fintros/SDrive-ARM/docs/SDriveARM_Board.pdf

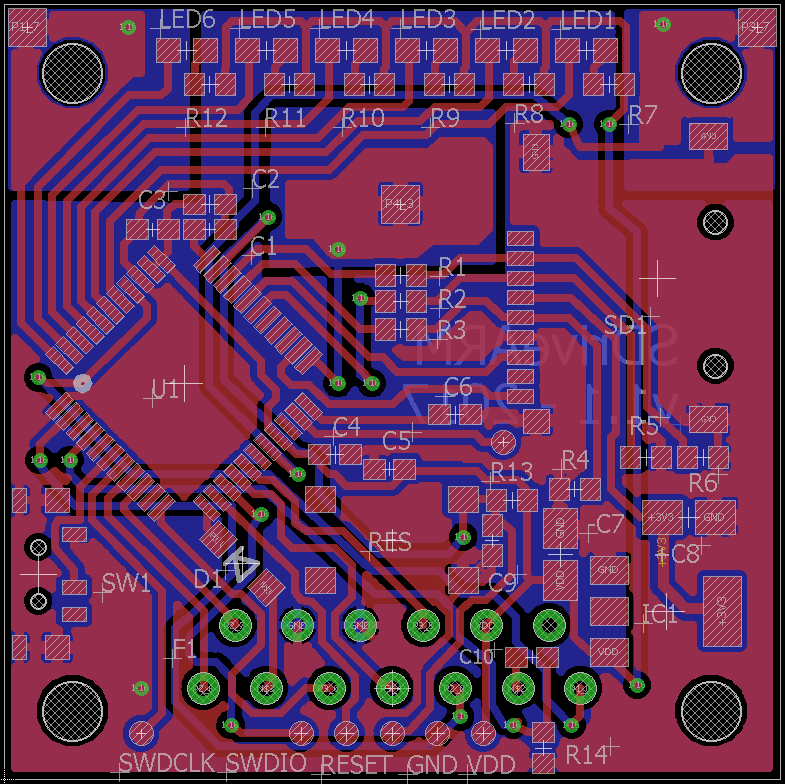
[picture p3: figure]
