fintros/SDrive-ARM/docs/photos/onplace01.jpg

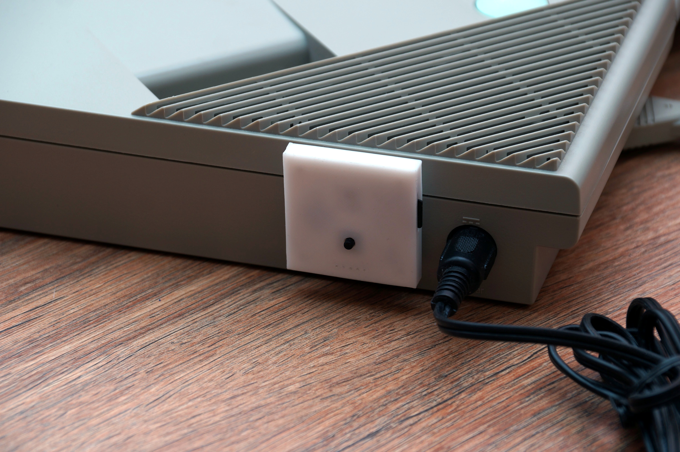
docs/photos/onplace01.jpg
