fintros/SDrive-ARM/docs/photos/onplace02.jpg

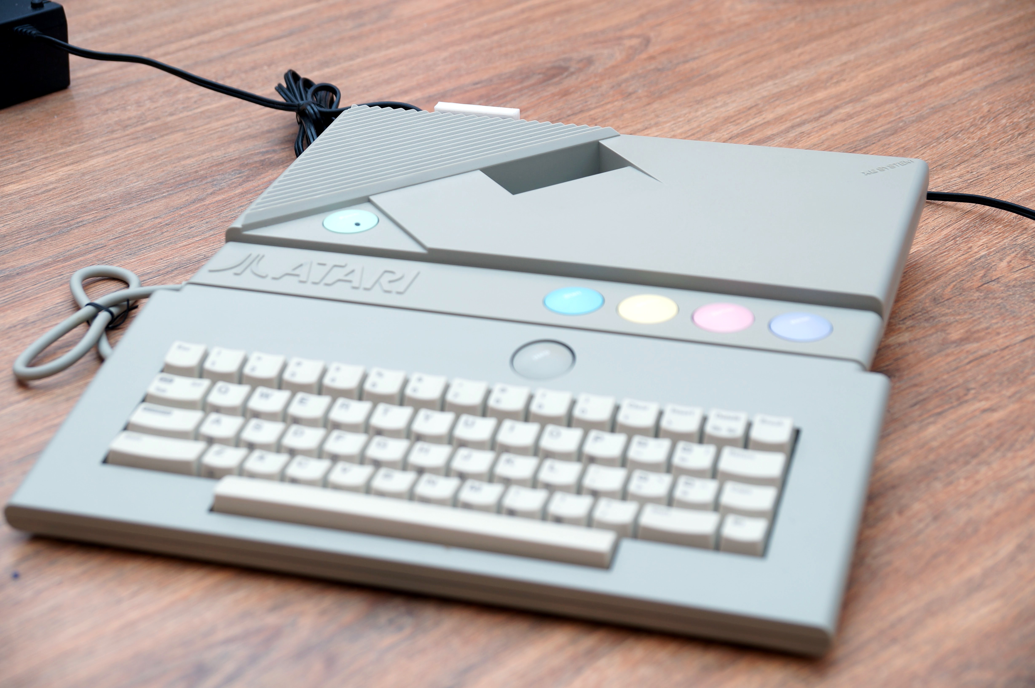
docs/photos/onplace02.jpg
