fintros/SDrive-ARM/docs/photos/onplace03.jpg

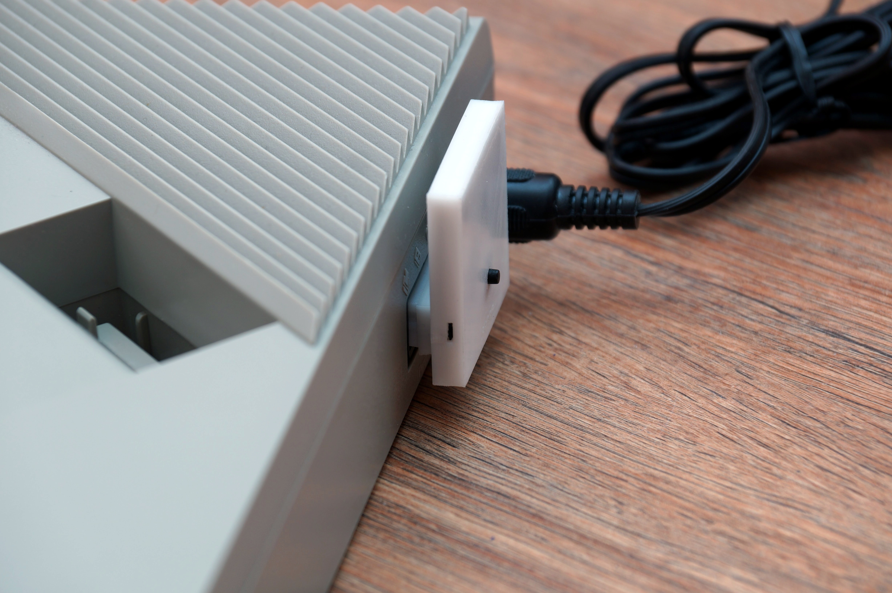
docs/photos/onplace03.jpg
