fintros/SDrive-ARM/docs/photos/onplace04.jpg

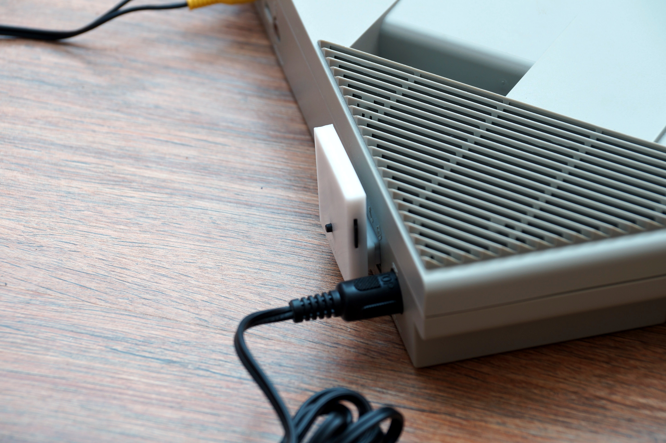
docs/photos/onplace04.jpg
