fintros/SDrive-ARM/docs/photos/onplace05.jpg

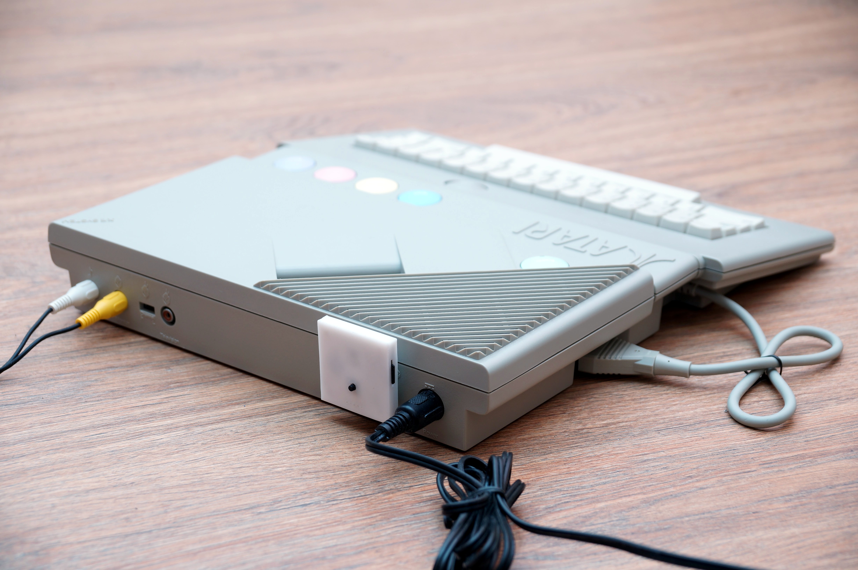
docs/photos/onplace05.jpg
