fintros/SDrive-ARM/docs/photos/view01.jpg

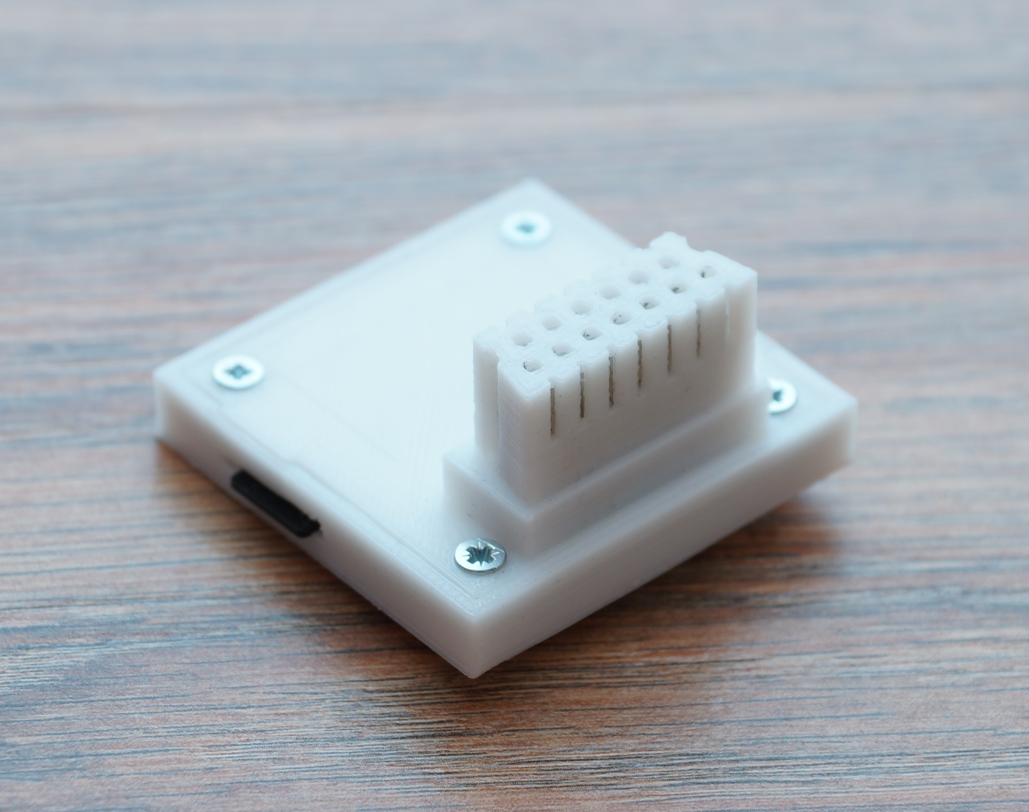
docs/photos/view01.jpg
