fintros/SDrive-ARM/docs/photos/view02.jpg

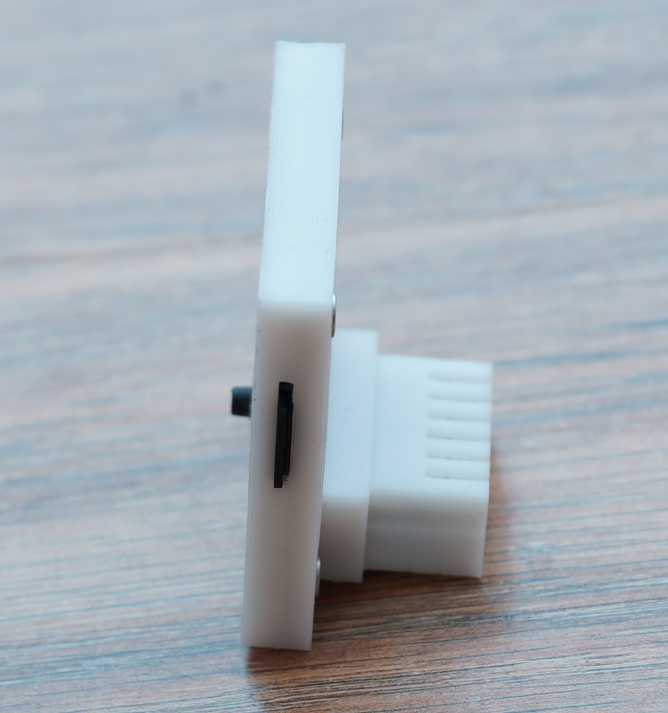
docs/photos/view02.jpg
