fintros/SDrive-ARM/docs/photos/view03.jpg

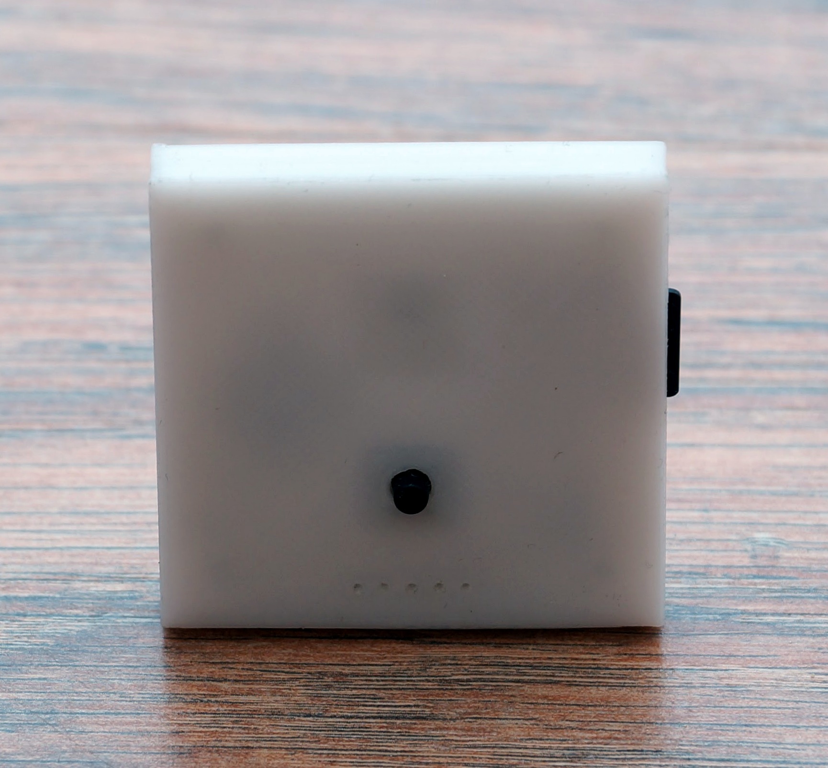
docs/photos/view03.jpg
