fintros/SDrive-ARM/docs/photos/view04.jpg

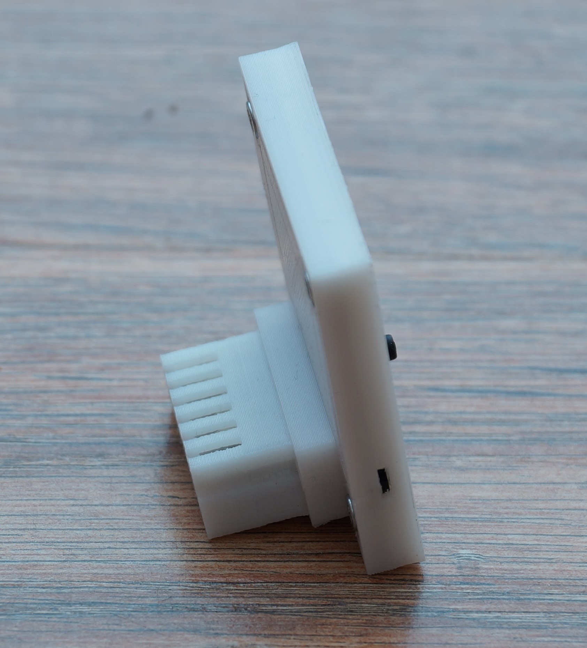
docs/photos/view04.jpg
