fintros/SDrive-ARM/docs/SDriveARM_Board.png

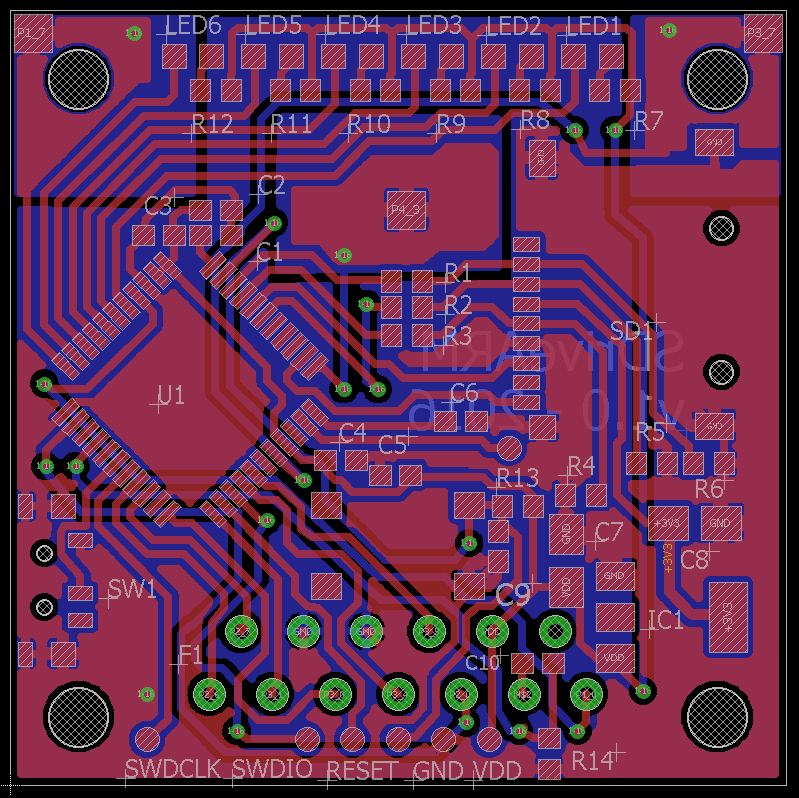
docs/SDriveARM_Board.png
