fintros/SDrive-ARM/box/bot.stl

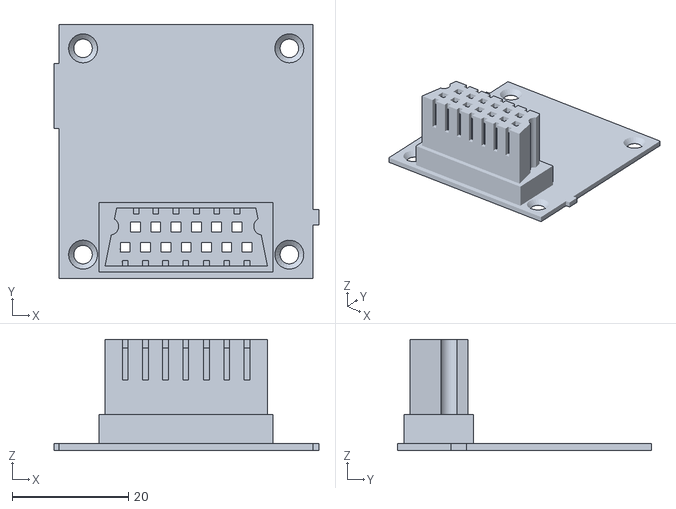
[picture p14: CAD file, 2022-09-16]
box/bot.stl
45.7 x 43.8 x 19.2
