fintros/SDrive-ARM/box/top.stl

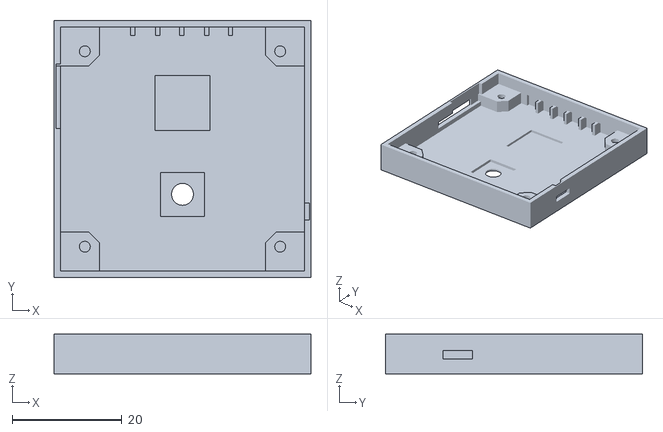
[picture p15: CAD file, 2022-09-16]
box/top.stl
46.8 x 46.8 x 7.21
