fintros/SDrive-ARM/docs/photos/build01.jpg

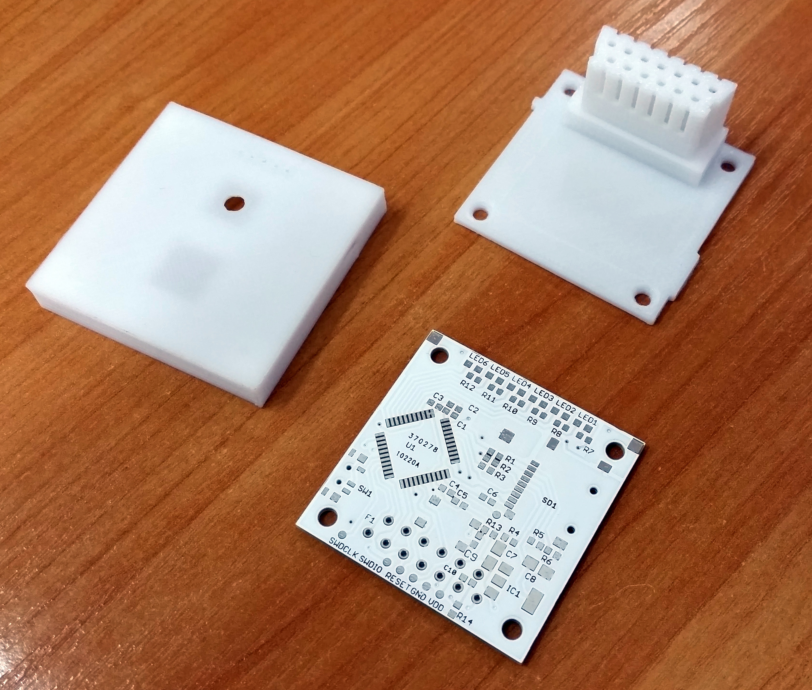
docs/photos/build01.jpg
