fintros/SDrive-ARM/docs/photos/build02.jpg

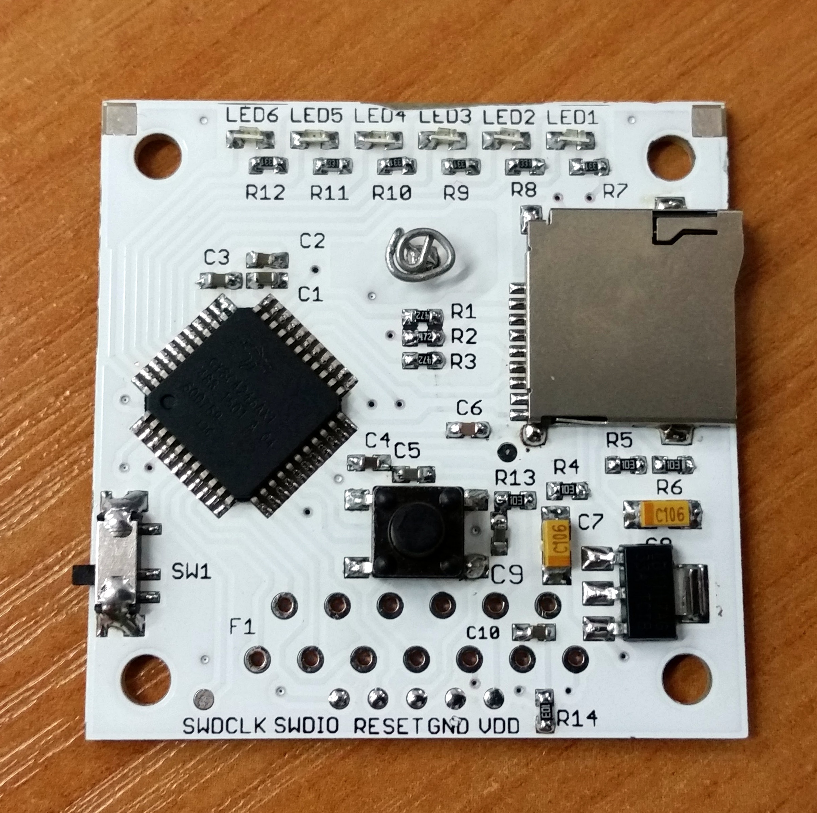
docs/photos/build02.jpg
