fintros/SDrive-ARM/docs/photos/build03.jpg

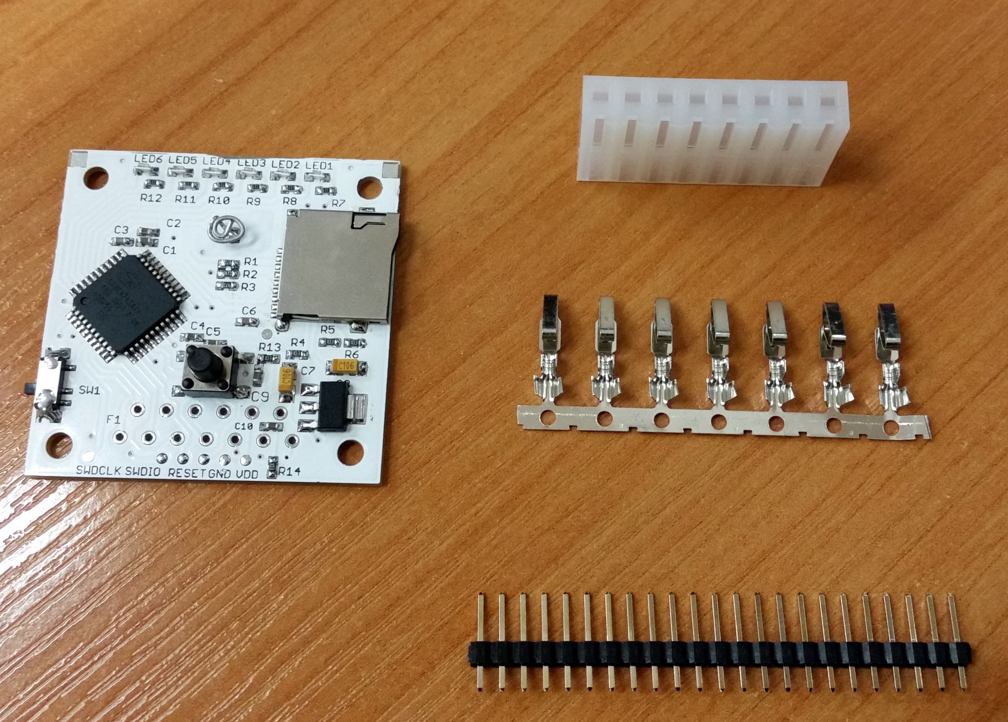
docs/photos/build03.jpg
