fintros/SDrive-ARM/docs/photos/build04.jpg

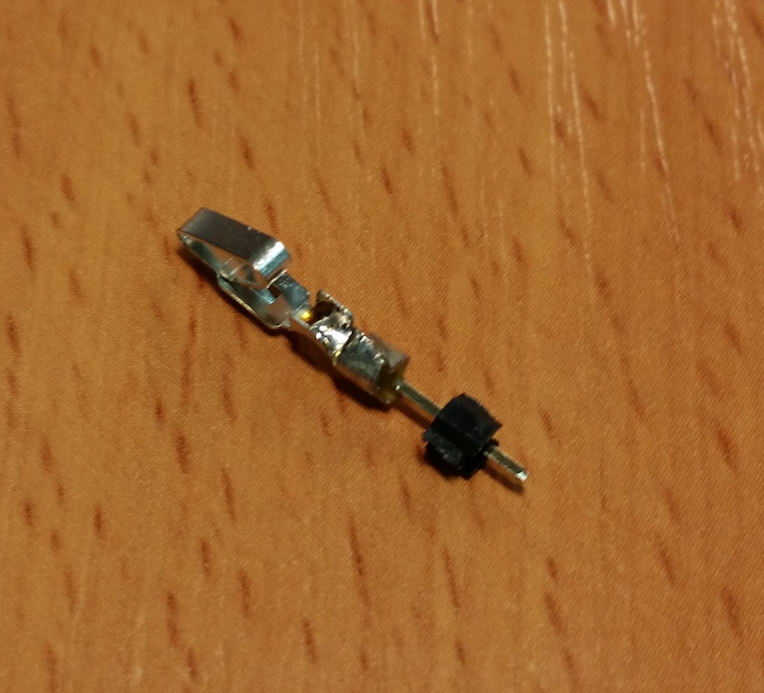
docs/photos/build04.jpg
