fintros/SDrive-ARM/docs/photos/build05.jpg

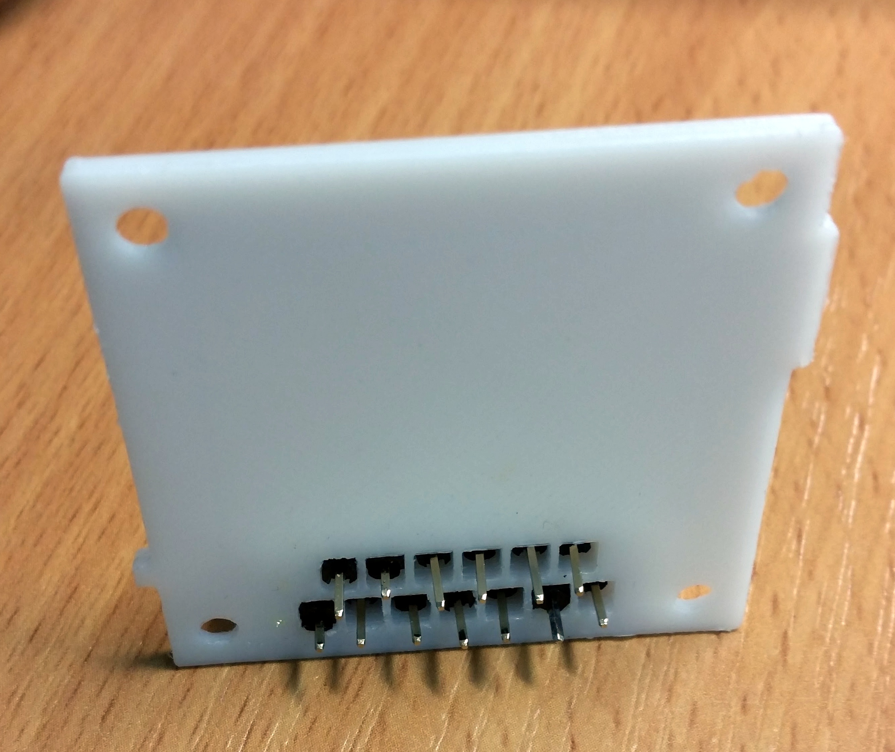
docs/photos/build05.jpg
