fintros/SDrive-ARM/docs/photos/build06.jpg

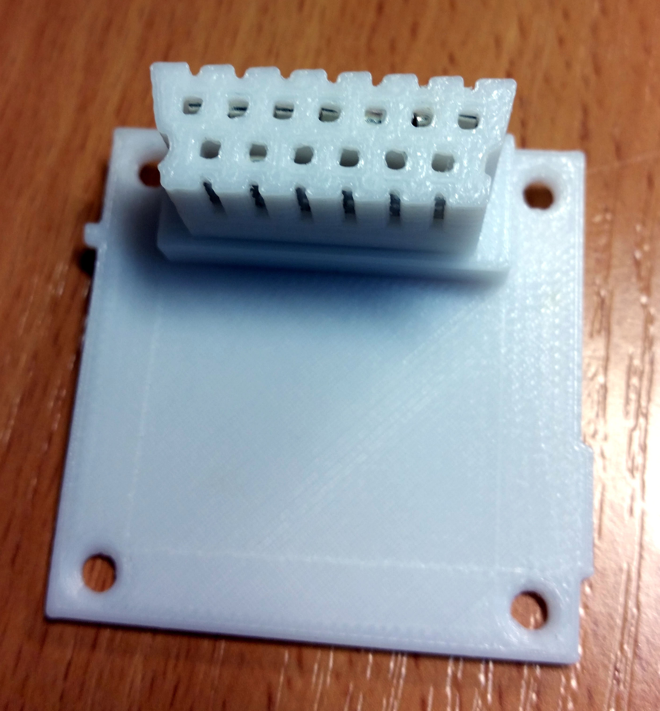
docs/photos/build06.jpg
