fintros/SDrive-ARM/docs/SDriveARM_Scheme.pdf

## MicroSD card Processor

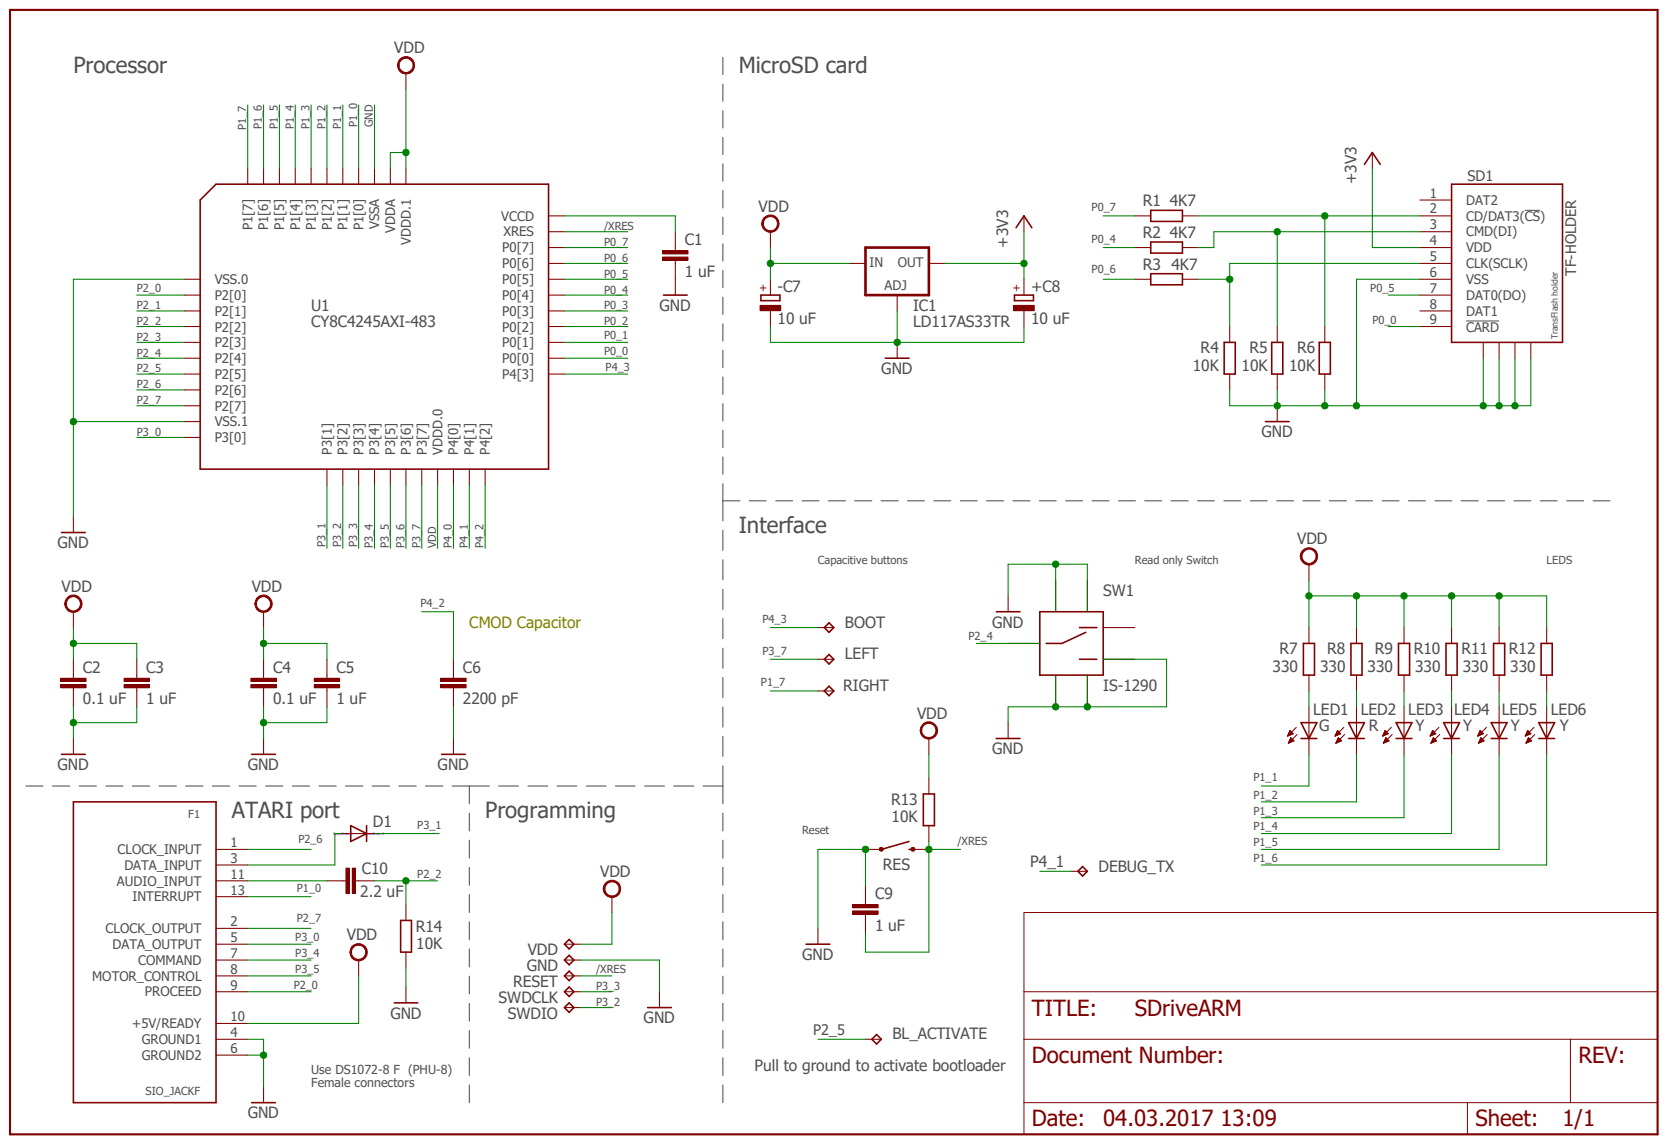
[picture p22: page 1]

CMD(DI) 3
VDD 4

VSS 6
