fintros/SDrive-ARM/hardware/SDriveARM.brd

## EAGLE design hardware/SDriveARM.brd (2017-03-04)

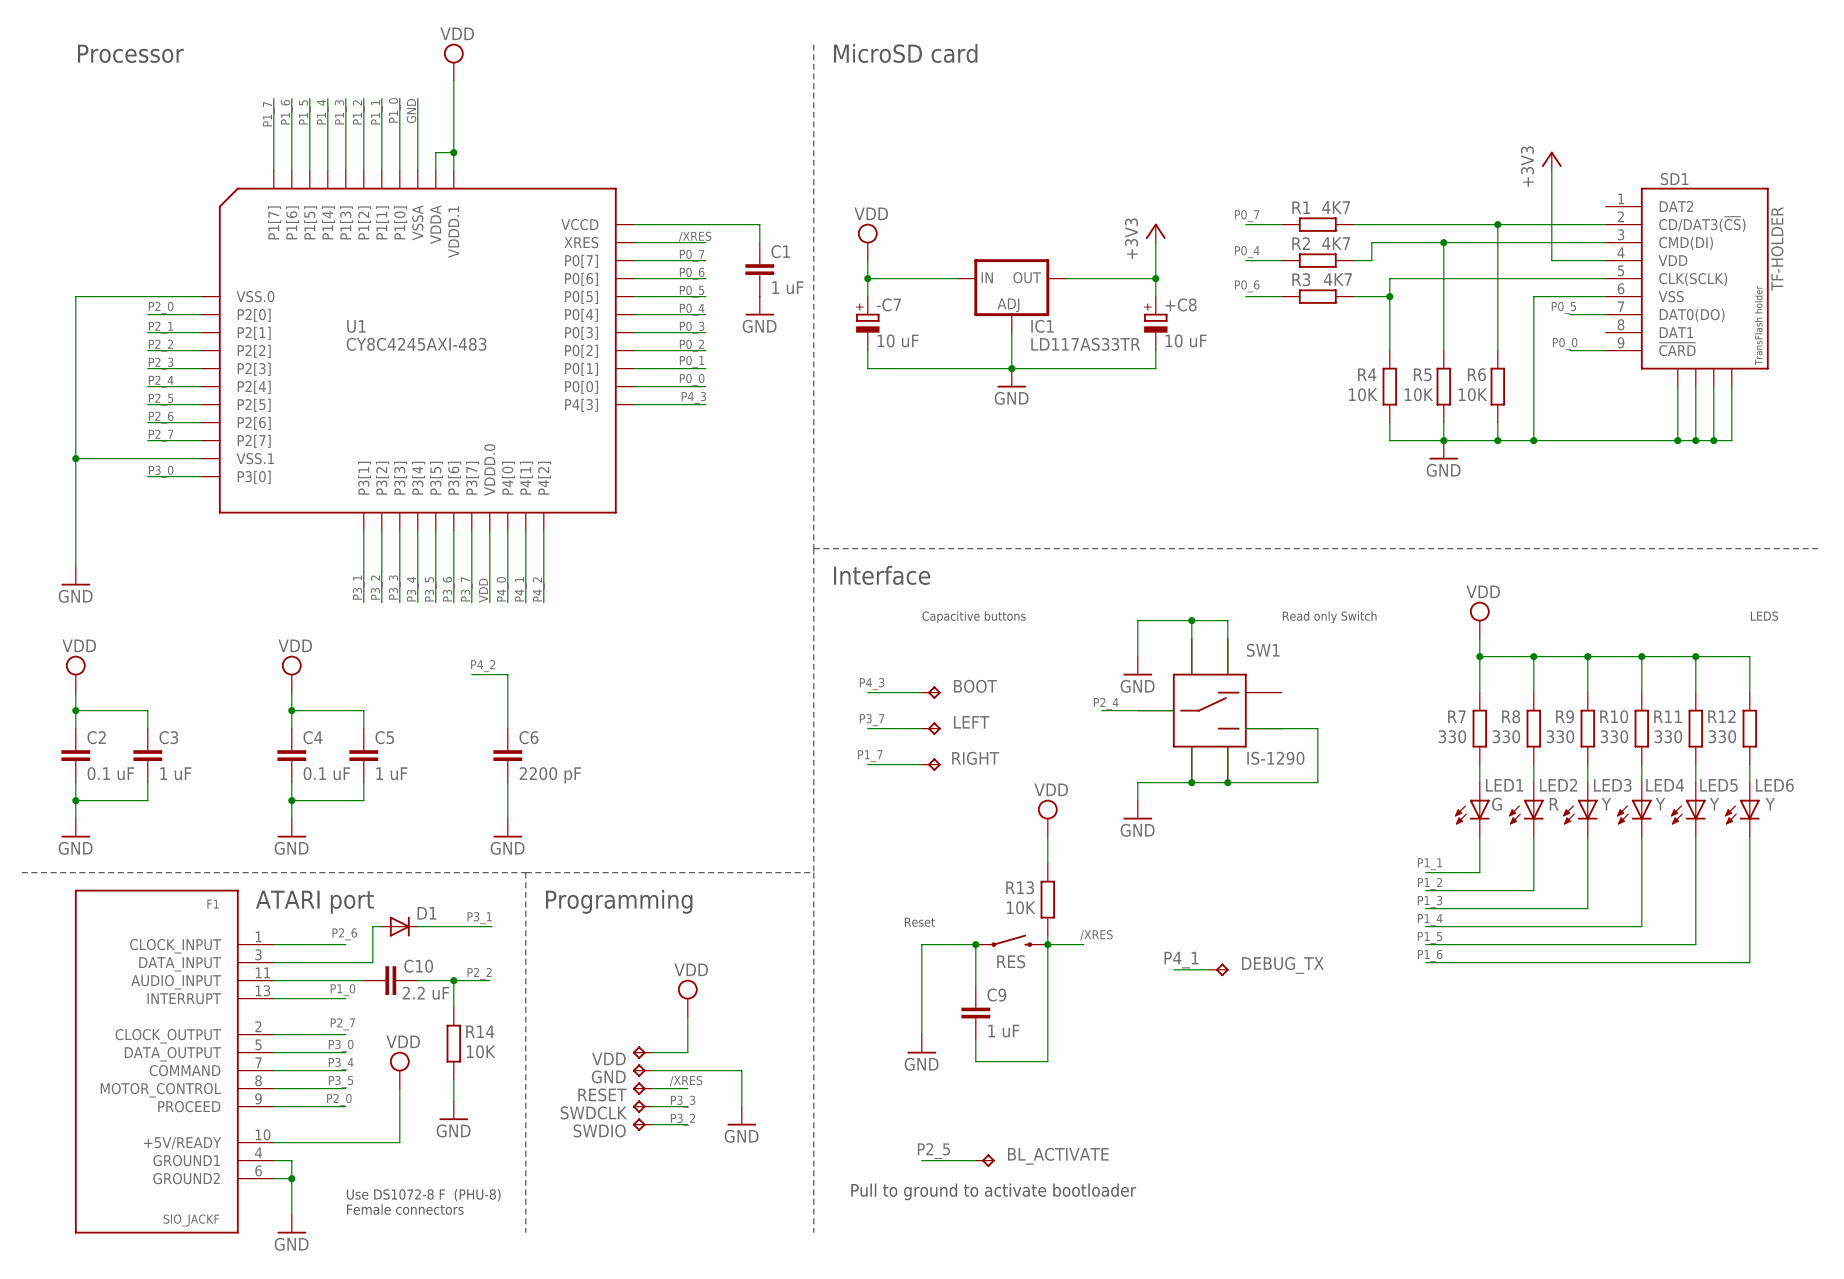
[picture p23: schematic SDriveARM.sch]

Parts:
+C8: 10 uF; A/3216-18W
-C7: 10 uF; A/3216-18W
BL_ACTIVATE: TPB1,27; B1,27
BOOT: TPTP20SQ; TP20SQ
C1, C3, C5, C9: 1 uF; C0603
C2, C4: 0.1 uF; C0603
C6: 2200 pF; C0603
C10: 2.2 uF; C0603
D1: MBR0520LT; SOD123
DEBUG_TX: TPB1,27; B1,27
F1: SIO_JACKF; SIO_JACK_F
GND: TPB1,27; B1,27
IC1: LD117AS33TR; SOT223
LED1: G; SML0805
LED2: R; SML0805
LED3, LED4, LED5, LED6: Y; SML0805
LEFT: TPTP20SQ; TP20SQ
R1, R2, R3: 4K7; R0603
R4, R5, R6, R13, R14: 10K; R0603
R7, R8, R9, R10, R11, R12: 330; R0603
RES: SWITCH-MOMENTARY-2; TACTILE_SWITCH_TALL
RESET: TPB1,27; B1,27
RIGHT: TPTP20SQ; TP20SQ
SD1: TF-HOLDER; TF-PULL
SW1: IS-1290
SWDCLK: TPB1,27; B1,27
SWDIO: TPB1,27; B1,27
U1: CY8C4245AXI-483; TQFP44
VDD: TPB1,27; B1,27

Connections:
+3V3: +C8.+, IC1.4 (OUT), SD1.4 (VDD)
/XRES: C9.2, R13.1, RES.B2 (2), RESET.TP, U1.32 (XRES)
GND: +C8.-, -C7.-, C1.2, C2.2, C3.2, C4.2, C5.2, C6.2, C9.1, F1.4 (GROUND1), F1.6 (GROUND2), GND.TP, IC1.1 (ADJ), R4.1, R5.1, R6.1, R14.1, RES.A2 (1), SD1.6 (VSS), SD1.S1, SD1.S2, SD1.S3, SD1.S4, SW1.POS2, SW1.SHIELD$1, SW1.SHIELD$2, SW1.SHIELD$3, SW1.SHIELD$4, U1.1 (VSS.0), U1.10 (VSS.1), U1.36 (VSSA)
unnamed: C1.1, U1.33 (VCCD)
unnamed: C10.2, F1.11 (AUDIO_INPUT)
unnamed: D1.A, F1.3 (DATA_INPUT)
unnamed: R1.2, R6.2, SD1.2 (CD/DAT3(!CS!))
unnamed: R2.2, R5.2, SD1.3 (CMD(DI))
unnamed: R3.2, R4.2, SD1.5 (CLK(SCLK))
unnamed: LED1.A, R7.1
unnamed: LED2.A, R8.1
unnamed: LED3.A, R9.1
unnamed: LED4.A, R10.1
unnamed: LED5.A, R11.1
unnamed: LED6.A, R12.1
P0_0: SD1.9 (!CARD), U1.24 (P0[0])
P0_1: U1.25 (P0[1])
P0_2: U1.26 (P0[2])
P0_3: U1.27 (P0[3])
P0_4: R2.1, U1.28 (P0[4])
P0_5: SD1.7 (DAT0(DO)), U1.29 (P0[5])
P0_6: R3.1, U1.30 (P0[6])
P0_7: R1.1, U1.31 (P0[7])
P1_0: F1.13 (INTERRUPT), U1.37 (P1[0])
P1_1: LED1.C, U1.38 (P1[1])
P1_2: LED2.C, U1.39 (P1[2])
P1_3: LED3.C, U1.40 (P1[3])
P1_4: LED4.C, U1.41 (P1[4])
P1_5: LED5.C, U1.42 (P1[5])
P1_6: LED6.C, U1.43 (P1[6])
P1_7: RIGHT.TP, U1.44 (P1[7])
P2_0: F1.9 (PROCEED), U1.2 (P2[0])
P2_1: U1.3 (P2[1])
P2_2: C10.1, R14.2, U1.4 (P2[2])
P2_3: U1.5 (P2[3])
P2_4: SW1.COMMON, U1.6 (P2[4])
P2_5: BL_ACTIVATE.TP, U1.7 (P2[5])
P2_6: F1.1 (CLOCK_INPUT), U1.8 (P2[6])
P2_7: F1.2 (CLOCK_OUTPUT), U1.9 (P2[7])
P3_0: F1.5 (DATA_OUTPUT), U1.11 (P3[0])
P3_1: D1.C, U1.12 (P3[1])
P3_2: SWDIO.TP, U1.13 (P3[2])
P3_3: SWDCLK.TP, U1.14 (P3[3])
P3_4: F1.7 (COMMAND), U1.15 (P3[4])
P3_5: F1.8 (MOTOR_CONTROL), U1.16 (P3[5])
P3_6: U1.17 (P3[6])
P3_7: LEFT.TP, U1.18 (P3[7])
P4_0: U1.20 (P4[0])
P4_1: DEBUG_TX.TP, U1.21 (P4[1])
P4_2: C6.1, U1.22 (P4[2])
P4_3: BOOT.TP, U1.23 (P4[3])
VDD: -C7.+, C2.1, C3.1, C4.1, C5.1, F1.10 (+5V/READY), IC1.3 (IN), R7.2, R8.2, R9.2, R10.2, R11.2, R12.2, R13.2, U1.19 (VDDD.0), U1.34 (VDDD.1), U1.35 (VDDA), VDD.TP

Notes on the sheet:
Read only Switch
Capacitive buttons
Programming
MicroSD card
Interface
Processor
ATARI port
Reset
LEDS
Pull to ground to activate bootloader
Use DS1072-8 F (PHU-8) Female connectors

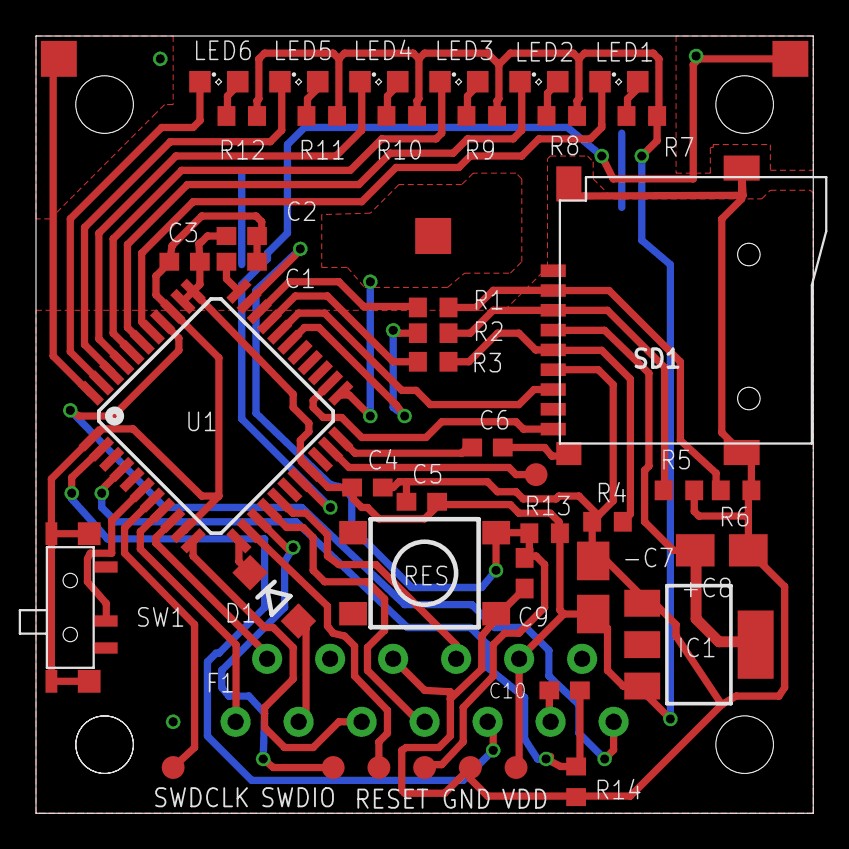
[picture p24: board SDriveARM.brd from above]

Board: 2 copper layers, 43.2 x 43.2 mm, 47 parts (0 on the bottom side), 45 nets.
