fintros/SDrive-ARM/(commit log)

2016-12-02 Add LEDS and buttons
2016-12-06 Switch to CapSense buttons
2017-02-14 Reorganize, add Box for 3D printing and PCB source and gerber files
    [SDriveARM.brd, SDriveARM.sch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]
2017-02-14 Add's documents and photos
    [SDriveARM.sch]
2017-02-14 Add SD files and native source code
    [SDRIVE.CFG]
2017-02-26 Add 8 drives support
    8 drives working, but configurations for 8 drives not saved yet - ToDo
    [SDRIVE.CFG]
2017-02-26 Remove unused CFG
    [SDRIVE.CFG]
2017-03-04 Update HW design to v1.1
    Add diode to "SIO data in" to allow work in chain
    [SDriveARM.brd, SDriveARM.sch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]
2017-03-05 Fix config load/save behavior for 8 drives
    [SDRIVE.CFG]
2017-03-05 Fix bug with FAT32 directory listing
    [SDrive.c, fat.c]
2017-04-01 Bootloader temp
    Temporary version of bootloader
    [SDRIVE.CFG]
2017-04-02 Fix bootloader adresses and slow down bug
    [HWContext.cpp, HWContext.h, SDrive.c, fat.c]
2017-04-05 First stable version of bootloader
    Version stabilized, prebuilt bootloader binaries prepared to use
    [HWContext.cpp, HWContext.h, SDAccess.cpp, SDAccess.h, SDrive.c, dprint.c, fat.c, fat.h]
2017-07-10 Fix issue with misalligned access with FAT16
    There was bug detected with FAT16 operations on ARM.
    To fix it in bootloader, bootloader updater is needed
    [fat.c]
2017-10-04 Fix bootloader to support Kingston 2Mb cards
    Some card would not to initialize with current sequence, but after reset
    works fine. Simulate reset in error cases
    [SDAccess.cpp]
2017-10-04 Update version of FW + bootloader version detection
    Adds functionality to skip update with different bootloader version and
    update current version
    [main.c]
2018-11-08 Fix issue with 256-byte sectors
    [SDrive.c]
2022-09-16 Fix 3d models for printing
    [bot.stl, box_bot.obj, box_top.obj, top.stl]
