fintros/SDrive-ARM/(notices)

Notices in the files:
parts and their libraries:
atari: Copyright (c) 2010
Copyright (c) 2009
This library is licensed under the
Creative Commons Attribution 3.0 United States License.
SparkFun-Electromechanical: Licensing: CC v3.0 Share-Alike You are welcome to use this library for commercial purposes.
